jgui/Relays-Board-CAN-24FormC/README.md

# Relays-Board-CAN-24FormC
Board with 24 relays (Form C) controlled by CAN.
