jgui/Relays-Board-CAN-24FormC/PCB/RelaysCAN.kicad_pcb

## KiCad design PCB/RelaysCAN.kicad_pcb (2021-08-17)

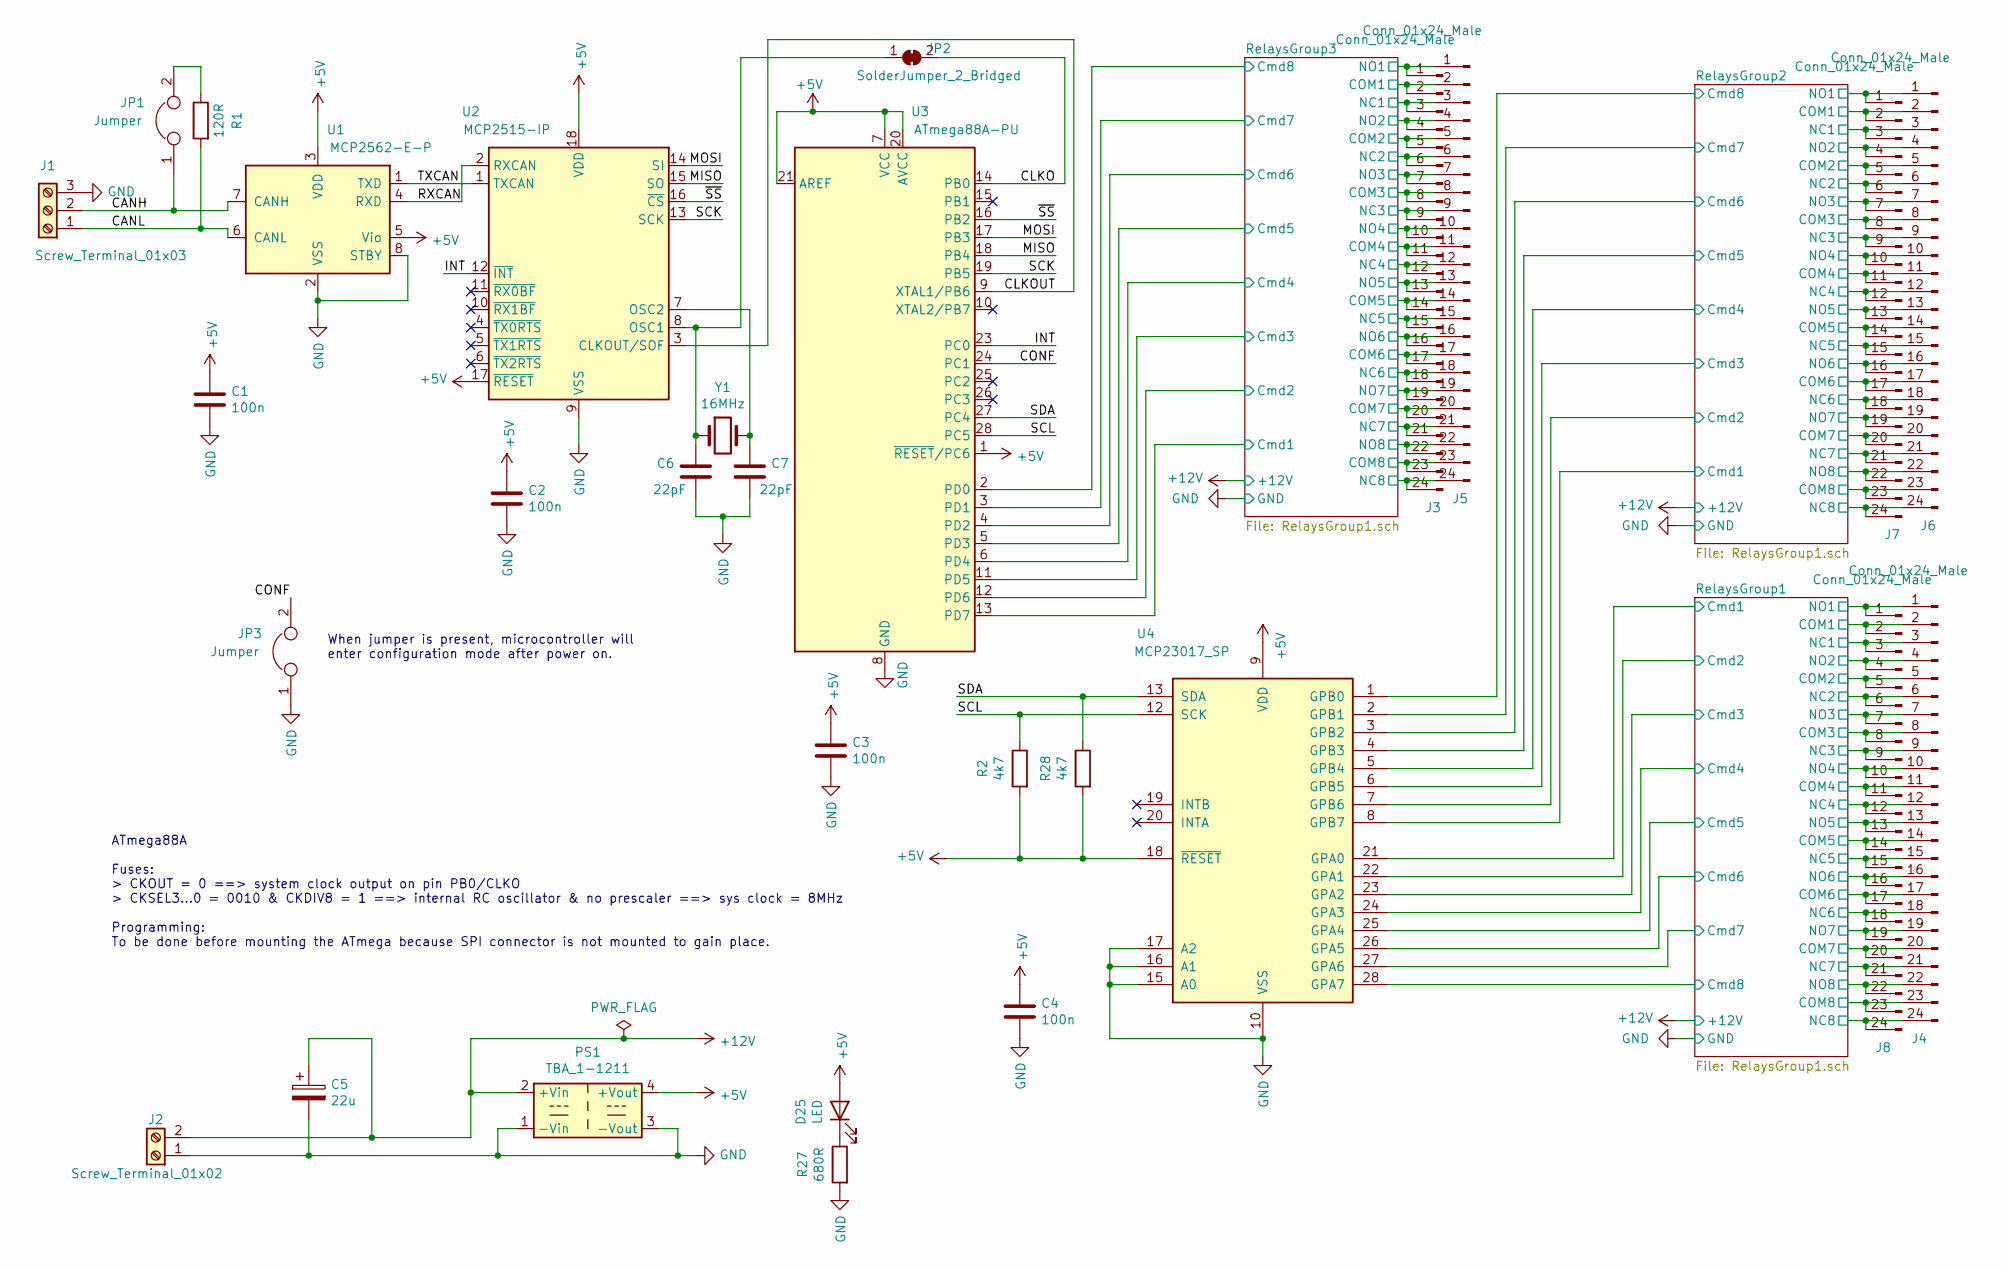
[picture p1: schematic RelaysCAN.sch, Relay board controlled by CAN.]

Parts:
C1, C2, C3, C4: 100n; C_Disc_D4.3mm_W1.9mm_P5.00mm
C5: 22u; CP_Radial_D5.0mm_P2.50mm
C6, C7: 22pF; C_Disc_D4.3mm_W1.9mm_P5.00mm
D25: LED; LED_D3.0mm
J1: Screw_Terminal_01x03; TerminalBlock_bornier-3_P5.08mm
J2: Screw_Terminal_01x02; TerminalBlock_bornier-2_P5.08mm
J3, J7, J8: Conn_01x24_Male; DualSideEdge_65x250mils_2.54mmx24pads
J4, J5, J6: Conn_01x24_Male; PinHeader_1x24_P2.54mm_Vertical
JP1, JP3: Jumper; PinHeader_1x02_P2.54mm_Vertical
JP2: SolderJumper_2_Bridged; SolderJumper-2_P1.3mm_Open_RoundedPad1.0x1.5mm
PS1: TBA_1-1211; Converter_DCDC_TRACO_TBA-1-xxxx_Single_THT
R1: 120R; R_Axial_DIN0207_L6.3mm_D2.5mm_P5.08mm_Vertical
R2, R28: 4k7; R_Axial_DIN0207_L6.3mm_D2.5mm_P5.08mm_Vertical
R27: 680R; R_Axial_DIN0207_L6.3mm_D2.5mm_P5.08mm_Vertical
U1: MCP2562-E-P; DIP-8_W7.62mm
U2: MCP2515-IP; DIP-18_W7.62mm_LongPads
U3: ATmega88A-PU; DIP-28_W7.62mm_LongPads
U4: MCP23017_SP; DIP-28_W7.62mm_LongPads
Y1: 16MHz; Crystal_HC18-U_Vertical

Connections:
+5V: C1.1, C2.1, C3.1, C4.1, D25.2 (A), PS1.4 (+Vout), R2.2, R28.2, U1.3 (VDD), U1.5 (Vio), U2.17 (~RESET), U2.18 (VDD), U3.1 (~RESET~/PC6), U3.7 (VCC), U3.20 (AVCC), U3.21 (AREF), U4.9 (VDD), U4.18 (~RESET~)
+12V: C5.1, J2.2, PS1.2 (+Vin); also elsewhere on the board
/CANH: J1.2, JP1.1, U1.7 (CANH)
/CANL: J1.1, R1.2, U1.6 (CANL)
/CLKO: JP2.2 (B), U3.14 (PB0)
/CLKOUT: U2.3 (CLKOUT/SOF), U3.9 (XTAL1/PB6)
/CONF: JP3.2, U3.24 (PC1)
/INT: U2.12 (~INT), U3.23 (PC0)
/MISO: U2.15 (SO), U3.18 (PB4)
/MOSI: U2.14 (SI), U3.17 (PB3)
/RXCAN: U1.4 (RXD), U2.2 (RXCAN)
/RelaysGroup1/COM1: J4.2, J8.2; also elsewhere on the board
/RelaysGroup1/COM2: J4.5, J8.5; also elsewhere on the board
/RelaysGroup1/COM3: J4.8, J8.8; also elsewhere on the board
/RelaysGroup1/COM4: J4.11, J8.11; also elsewhere on the board
/RelaysGroup1/COM5: J4.14, J8.14; also elsewhere on the board
/RelaysGroup1/COM6: J4.17, J8.17; also elsewhere on the board
/RelaysGroup1/COM7: J4.20, J8.20; also elsewhere on the board
/RelaysGroup1/COM8: J4.23, J8.23; also elsewhere on the board
/RelaysGroup1/Cmd1: U4.21 (GPA0); also elsewhere on the board
/RelaysGroup1/Cmd2: U4.22 (GPA1); also elsewhere on the board
/RelaysGroup1/Cmd3: U4.23 (GPA2); also elsewhere on the board
/RelaysGroup1/Cmd4: U4.24 (GPA3); also elsewhere on the board
/RelaysGroup1/Cmd5: U4.25 (GPA4); also elsewhere on the board
/RelaysGroup1/Cmd6: U4.26 (GPA5); also elsewhere on the board
/RelaysGroup1/Cmd7: U4.27 (GPA6); also elsewhere on the board
/RelaysGroup1/Cmd8: U4.28 (GPA7); also elsewhere on the board
/RelaysGroup1/NC1: J4.3, J8.3; also elsewhere on the board
/RelaysGroup1/NC2: J4.6, J8.6; also elsewhere on the board
/RelaysGroup1/NC3: J4.9, J8.9; also elsewhere on the board
/RelaysGroup1/NC4: J4.12, J8.12; also elsewhere on the board
/RelaysGroup1/NC5: J4.15, J8.15; also elsewhere on the board
/RelaysGroup1/NC6: J4.18, J8.18; also elsewhere on the board
/RelaysGroup1/NC7: J4.21, J8.21; also elsewhere on the board
/RelaysGroup1/NC8: J4.24, J8.24; also elsewhere on the board
/RelaysGroup1/NO1: J4.1, J8.1; also elsewhere on the board
/RelaysGroup1/NO2: J4.4, J8.4; also elsewhere on the board
/RelaysGroup1/NO3: J4.7, J8.7; also elsewhere on the board
/RelaysGroup1/NO4: J4.10, J8.10; also elsewhere on the board
/RelaysGroup1/NO5: J4.13, J8.13; also elsewhere on the board
/RelaysGroup1/NO6: J4.16, J8.16; also elsewhere on the board
/RelaysGroup1/NO7: J4.19, J8.19; also elsewhere on the board
/RelaysGroup1/NO8: J4.22, J8.22; also elsewhere on the board
/RelaysGroup2/COM1: J6.2, J7.2; also elsewhere on the board
/RelaysGroup2/COM2: J6.5, J7.5; also elsewhere on the board
/RelaysGroup2/COM3: J6.8, J7.8; also elsewhere on the board
/RelaysGroup2/COM4: J6.11, J7.11; also elsewhere on the board
/RelaysGroup2/COM5: J6.14, J7.14; also elsewhere on the board
/RelaysGroup2/COM6: J6.17, J7.17; also elsewhere on the board
/RelaysGroup2/COM7: J6.20, J7.20; also elsewhere on the board
/RelaysGroup2/COM8: J6.23, J7.23; also elsewhere on the board
/RelaysGroup2/Cmd1: U4.8 (GPB7); also elsewhere on the board
/RelaysGroup2/Cmd2: U4.7 (GPB6); also elsewhere on the board
/RelaysGroup2/Cmd3: U4.6 (GPB5); also elsewhere on the board
/RelaysGroup2/Cmd4: U4.5 (GPB4); also elsewhere on the board
/RelaysGroup2/Cmd5: U4.4 (GPB3); also elsewhere on the board
/RelaysGroup2/Cmd6: U4.3 (GPB2); also elsewhere on the board
/RelaysGroup2/Cmd7: U4.2 (GPB1); also elsewhere on the board
/RelaysGroup2/Cmd8: U4.1 (GPB0); also elsewhere on the board
/RelaysGroup2/NC1: J6.3, J7.3; also elsewhere on the board
/RelaysGroup2/NC2: J6.6, J7.6; also elsewhere on the board
/RelaysGroup2/NC3: J6.9, J7.9; also elsewhere on the board
/RelaysGroup2/NC4: J6.12, J7.12; also elsewhere on the board
/RelaysGroup2/NC5: J6.15, J7.15; also elsewhere on the board
/RelaysGroup2/NC6: J6.18, J7.18; also elsewhere on the board
/RelaysGroup2/NC7: J6.21, J7.21; also elsewhere on the board
/RelaysGroup2/NC8: J6.24, J7.24; also elsewhere on the board
/RelaysGroup2/NO1: J6.1, J7.1; also elsewhere on the board
/RelaysGroup2/NO2: J6.4, J7.4; also elsewhere on the board
/RelaysGroup2/NO3: J6.7, J7.7; also elsewhere on the board
/RelaysGroup2/NO4: J6.10, J7.10; also elsewhere on the board
/RelaysGroup2/NO5: J6.13, J7.13; also elsewhere on the board
/RelaysGroup2/NO6: J6.16, J7.16; also elsewhere on the board
/RelaysGroup2/NO7: J6.19, J7.19; also elsewhere on the board
/RelaysGroup2/NO8: J6.22, J7.22; also elsewhere on the board
/RelaysGroup3/COM1: J3.2, J5.2; also elsewhere on the board
/RelaysGroup3/COM2: J3.5, J5.5; also elsewhere on the board
/RelaysGroup3/COM3: J3.8, J5.8; also elsewhere on the board
/RelaysGroup3/COM4: J3.11, J5.11; also elsewhere on the board
/RelaysGroup3/COM5: J3.14, J5.14; also elsewhere on the board
/RelaysGroup3/COM6: J3.17, J5.17; also elsewhere on the board
/RelaysGroup3/COM7: J3.20, J5.20; also elsewhere on the board
/RelaysGroup3/COM8: J3.23, J5.23; also elsewhere on the board
/RelaysGroup3/Cmd1: U3.13 (PD7); also elsewhere on the board
/RelaysGroup3/Cmd2: U3.12 (PD6); also elsewhere on the board
/RelaysGroup3/Cmd3: U3.11 (PD5); also elsewhere on the board
/RelaysGroup3/Cmd4: U3.6 (PD4); also elsewhere on the board
/RelaysGroup3/Cmd5: U3.5 (PD3); also elsewhere on the board
/RelaysGroup3/Cmd6: U3.4 (PD2); also elsewhere on the board
/RelaysGroup3/Cmd7: U3.3 (PD1); also elsewhere on the board
/RelaysGroup3/Cmd8: U3.2 (PD0); also elsewhere on the board
/RelaysGroup3/NC1: J3.3, J5.3; also elsewhere on the board
/RelaysGroup3/NC2: J3.6, J5.6; also elsewhere on the board
/RelaysGroup3/NC3: J3.9, J5.9; also elsewhere on the board
/RelaysGroup3/NC4: J3.12, J5.12; also elsewhere on the board
/RelaysGroup3/NC5: J3.15, J5.15; also elsewhere on the board
/RelaysGroup3/NC6: J3.18, J5.18; also elsewhere on the board
/RelaysGroup3/NC7: J3.21, J5.21; also elsewhere on the board
/RelaysGroup3/NC8: J3.24, J5.24; also elsewhere on the board
/RelaysGroup3/NO1: J3.1, J5.1; also elsewhere on the board
/RelaysGroup3/NO2: J3.4, J5.4; also elsewhere on the board
/RelaysGroup3/NO3: J3.7, J5.7; also elsewhere on the board
/RelaysGroup3/NO4: J3.10, J5.10; also elsewhere on the board
/RelaysGroup3/NO5: J3.13, J5.13; also elsewhere on the board
/RelaysGroup3/NO6: J3.16, J5.16; also elsewhere on the board
/RelaysGroup3/NO7: J3.19, J5.19; also elsewhere on the board
/RelaysGroup3/NO8: J3.22, J5.22; also elsewhere on the board
/SCK: U2.13 (SCK), U3.19 (PB5)
/SCL: R2.1, U3.28 (PC5), U4.12 (SCK)
/SDA: R28.1, U3.27 (PC4), U4.13 (SDA)
/TXCAN: U1.1 (TXD), U2.1 (TXCAN)
/~SS: U2.16 (~CS), U3.16 (PB2)
GND: C1.2, C2.2, C3.2, C4.2, C5.2, C6.2, C7.2, J1.3, J2.1, JP3.1, PS1.1 (-Vin), PS1.3 (-Vout), R27.2, U1.2 (VSS), U1.8 (STBY), U2.9 (VSS), U3.8 (GND), U3.22 (GND), U4.10 (VSS), U4.15 (A0), U4.16 (A1), U4.17 (A2); also elsewhere on the board
unnamed: C6.1, JP2.1 (A), U2.8 (OSC1), Y1.1
unnamed: C7.1, U2.7 (OSC2), Y1.2
unnamed: D25.1 (K), R27.1
unnamed: JP1.2, R1.1

Notes on the sheet:
ATmega88A Fuses: > CKOUT = 0 ==> system clock output on pin PB0/CLKO > CKSEL3...0 = 0010 & CKDIV8 = 1 ==> internal RC oscillator & no prescaler ==> sys clock = 8MHz Programming: To be done before mounting the ATmega because SPI connector is not mounted to gain place.
When jumper is present, microcontroller will enter configuration mode after power on.

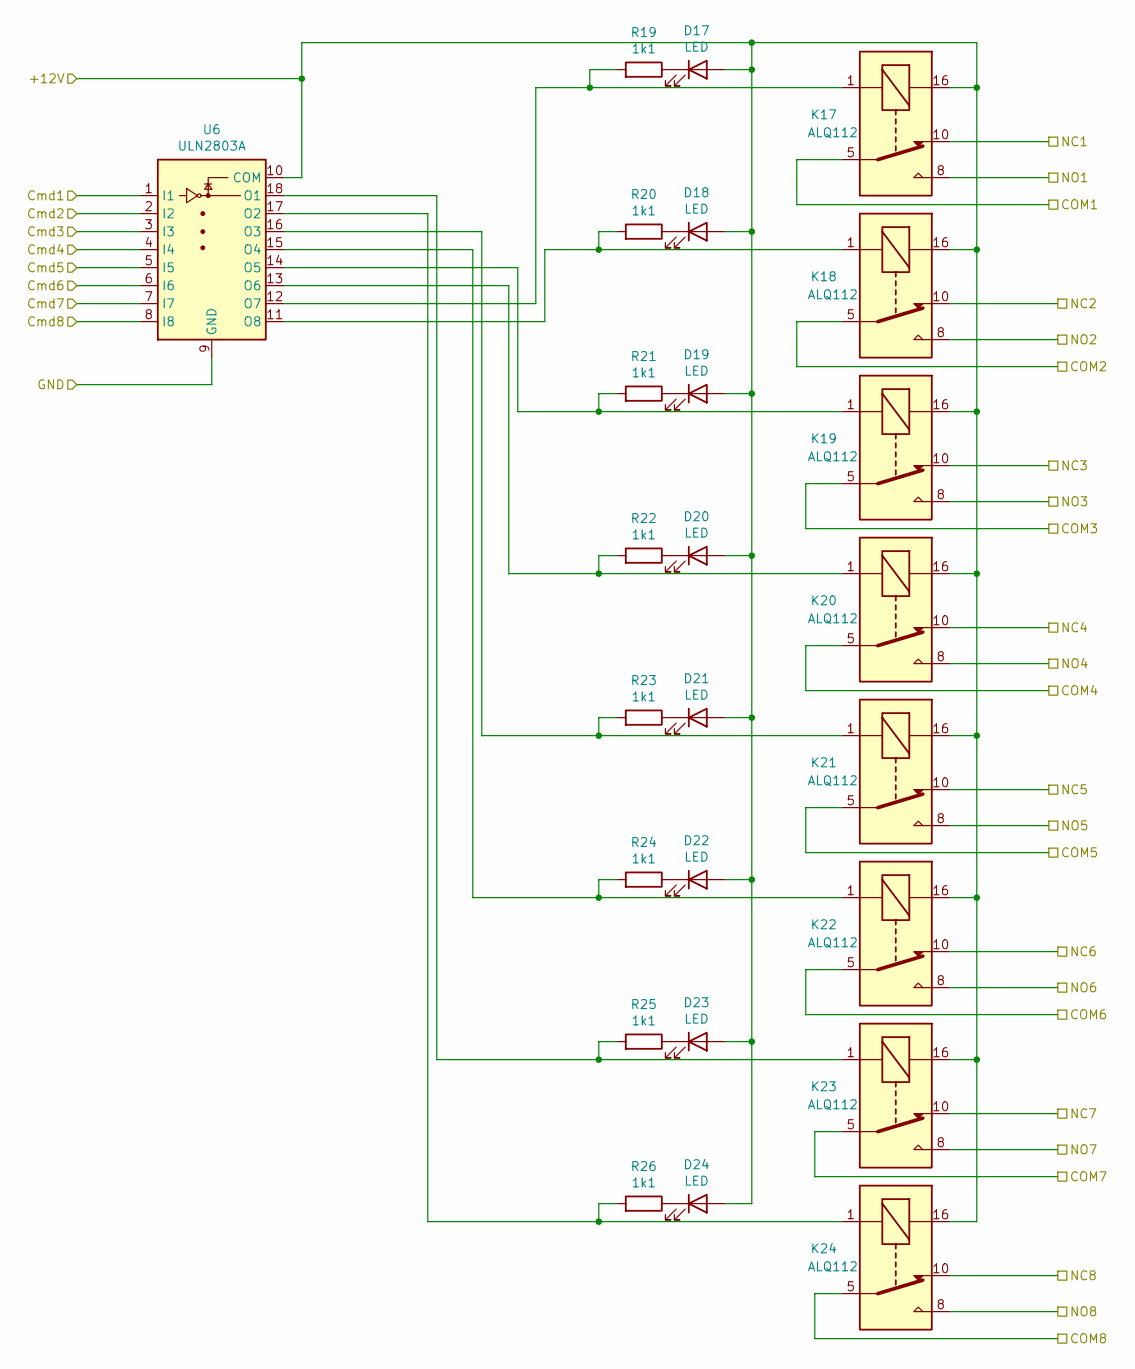
[picture p2: schematic RelaysGroup1.sch, Relay board controlled by CAN.]

Parts:
D1, D2, D3, D4, D5, D6, D7, D8: LED; LED_D3.0mm
K1, K2, K3, K4, K5, K6, K7, K8: ALQ112; Relay_Panasonic_ALQ112
R3, R4, R5, R6, R7, R8, R9, R10: 1k1; R_Axial_DIN0207_L6.3mm_D2.5mm_P5.08mm_Vertical
U7: ULN2803A; DIP-18_W7.62mm_LongPads

Connections:
+12V: D1.2 (A), D2.2 (A), D3.2 (A), D4.2 (A), D5.2 (A), D6.2 (A), D7.2 (A), D8.2 (A), K1.16, K2.16, K3.16, K4.16, K5.16, K6.16, K7.16, K8.16, U7.10 (COM); also elsewhere on the board
/RelaysGroup1/COM1: K1.5; also elsewhere on the board
/RelaysGroup1/COM2: K2.5; also elsewhere on the board
/RelaysGroup1/COM3: K3.5; also elsewhere on the board
/RelaysGroup1/COM4: K4.5; also elsewhere on the board
/RelaysGroup1/COM5: K5.5; also elsewhere on the board
/RelaysGroup1/COM6: K6.5; also elsewhere on the board
/RelaysGroup1/COM7: K7.5; also elsewhere on the board
/RelaysGroup1/COM8: K8.5; also elsewhere on the board
/RelaysGroup1/Cmd1: U7.1 (I1); also elsewhere on the board
/RelaysGroup1/Cmd2: U7.2 (I2); also elsewhere on the board
/RelaysGroup1/Cmd3: U7.3 (I3); also elsewhere on the board
/RelaysGroup1/Cmd4: U7.4 (I4); also elsewhere on the board
/RelaysGroup1/Cmd5: U7.5 (I5); also elsewhere on the board
/RelaysGroup1/Cmd6: U7.6 (I6); also elsewhere on the board
/RelaysGroup1/Cmd7: U7.7 (I7); also elsewhere on the board
/RelaysGroup1/Cmd8: U7.8 (I8); also elsewhere on the board
/RelaysGroup1/NC1: K1.10; also elsewhere on the board
/RelaysGroup1/NC2: K2.10; also elsewhere on the board
/RelaysGroup1/NC3: K3.10; also elsewhere on the board
/RelaysGroup1/NC4: K4.10; also elsewhere on the board
/RelaysGroup1/NC5: K5.10; also elsewhere on the board
/RelaysGroup1/NC6: K6.10; also elsewhere on the board
/RelaysGroup1/NC7: K7.10; also elsewhere on the board
/RelaysGroup1/NC8: K8.10; also elsewhere on the board
/RelaysGroup1/NO1: K1.8; also elsewhere on the board
/RelaysGroup1/NO2: K2.8; also elsewhere on the board
/RelaysGroup1/NO3: K3.8; also elsewhere on the board
/RelaysGroup1/NO4: K4.8; also elsewhere on the board
/RelaysGroup1/NO5: K5.8; also elsewhere on the board
/RelaysGroup1/NO6: K6.8; also elsewhere on the board
/RelaysGroup1/NO7: K7.8; also elsewhere on the board
/RelaysGroup1/NO8: K8.8; also elsewhere on the board
GND: U7.9 (GND); also elsewhere on the board
unnamed: D1.1 (K), R3.1
unnamed: D2.1 (K), R4.1
unnamed: D3.1 (K), R5.1
unnamed: D4.1 (K), R6.1
unnamed: D5.1 (K), R7.1
unnamed: D6.1 (K), R8.1
unnamed: D7.1 (K), R9.1
unnamed: D8.1 (K), R10.1
unnamed: K1.1, R3.2, U7.12 (O7)
unnamed: K2.1, R4.2, U7.11 (O8)
unnamed: K3.1, R5.2, U7.14 (O5)
unnamed: K4.1, R6.2, U7.13 (O6)
unnamed: K5.1, R7.2, U7.16 (O3)
unnamed: K6.1, R8.2, U7.15 (O4)
unnamed: K7.1, R9.2, U7.18 (O1)
unnamed: K8.1, R10.2, U7.17 (O2)

Parts of its further copies:
D9, D10, D11, D12, D13, D14, D15, D16, D17, D18, D19, D20, D21, D22, D23, D24: LED; LED_D3.0mm
K9, K10, K11, K12, K13, K14, K15, K16, K17, K18, K19, K20, K21, K22, K23, K24: ALQ112; Relay_Panasonic_ALQ112
R11, R12, R13, R14, R15, R16, R17, R18, R19, R20, R21, R22, R23, R24, R25, R26: 1k1; R_Axial_DIN0207_L6.3mm_D2.5mm_P5.08mm_Vertical
U5, U6: ULN2803A; DIP-18_W7.62mm_LongPads

Connections of its further copies:
+12V: D9.2 (A), D10.2 (A), D11.2 (A), D12.2 (A), D13.2 (A), D14.2 (A), D15.2 (A), D16.2 (A), D17.2 (A), D18.2 (A), D19.2 (A), D20.2 (A), D21.2 (A), D22.2 (A), D23.2 (A), D24.2 (A), K9.16, K10.16, K11.16, K12.16, K13.16, K14.16, K15.16, K16.16, K17.16, K18.16, K19.16, K20.16, K21.16, K22.16, K23.16, K24.16, U5.10 (COM), U6.10 (COM); also elsewhere on the board
/RelaysGroup2/COM1: K9.5; also elsewhere on the board
/RelaysGroup2/COM2: K10.5; also elsewhere on the board
/RelaysGroup2/COM3: K11.5; also elsewhere on the board
/RelaysGroup2/COM4: K12.5; also elsewhere on the board
/RelaysGroup2/COM5: K13.5; also elsewhere on the board
/RelaysGroup2/COM6: K14.5; also elsewhere on the board
/RelaysGroup2/COM7: K15.5; also elsewhere on the board
/RelaysGroup2/COM8: K16.5; also elsewhere on the board
/RelaysGroup2/Cmd1: U5.1 (I1); also elsewhere on the board
/RelaysGroup2/Cmd2: U5.2 (I2); also elsewhere on the board
/RelaysGroup2/Cmd3: U5.3 (I3); also elsewhere on the board
/RelaysGroup2/Cmd4: U5.4 (I4); also elsewhere on the board
/RelaysGroup2/Cmd5: U5.5 (I5); also elsewhere on the board
/RelaysGroup2/Cmd6: U5.6 (I6); also elsewhere on the board
/RelaysGroup2/Cmd7: U5.7 (I7); also elsewhere on the board
/RelaysGroup2/Cmd8: U5.8 (I8); also elsewhere on the board
/RelaysGroup2/NC1: K9.10; also elsewhere on the board
/RelaysGroup2/NC2: K10.10; also elsewhere on the board
/RelaysGroup2/NC3: K11.10; also elsewhere on the board
/RelaysGroup2/NC4: K12.10; also elsewhere on the board
/RelaysGroup2/NC5: K13.10; also elsewhere on the board
/RelaysGroup2/NC6: K14.10; also elsewhere on the board
/RelaysGroup2/NC7: K15.10; also elsewhere on the board
/RelaysGroup2/NC8: K16.10; also elsewhere on the board
/RelaysGroup2/NO1: K9.8; also elsewhere on the board
/RelaysGroup2/NO2: K10.8; also elsewhere on the board
/RelaysGroup2/NO3: K11.8; also elsewhere on the board
/RelaysGroup2/NO4: K12.8; also elsewhere on the board
/RelaysGroup2/NO5: K13.8; also elsewhere on the board
/RelaysGroup2/NO6: K14.8; also elsewhere on the board
/RelaysGroup2/NO7: K15.8; also elsewhere on the board
/RelaysGroup2/NO8: K16.8; also elsewhere on the board
/RelaysGroup3/COM1: K17.5; also elsewhere on the board
/RelaysGroup3/COM2: K18.5; also elsewhere on the board
/RelaysGroup3/COM3: K19.5; also elsewhere on the board
/RelaysGroup3/COM4: K20.5; also elsewhere on the board
/RelaysGroup3/COM5: K21.5; also elsewhere on the board
/RelaysGroup3/COM6: K22.5; also elsewhere on the board
/RelaysGroup3/COM7: K23.5; also elsewhere on the board
/RelaysGroup3/COM8: K24.5; also elsewhere on the board
/RelaysGroup3/Cmd1: U6.1 (I1); also elsewhere on the board
/RelaysGroup3/Cmd2: U6.2 (I2); also elsewhere on the board
/RelaysGroup3/Cmd3: U6.3 (I3); also elsewhere on the board
/RelaysGroup3/Cmd4: U6.4 (I4); also elsewhere on the board
/RelaysGroup3/Cmd5: U6.5 (I5); also elsewhere on the board
/RelaysGroup3/Cmd6: U6.6 (I6); also elsewhere on the board
/RelaysGroup3/Cmd7: U6.7 (I7); also elsewhere on the board
/RelaysGroup3/Cmd8: U6.8 (I8); also elsewhere on the board
/RelaysGroup3/NC1: K17.10; also elsewhere on the board
/RelaysGroup3/NC2: K18.10; also elsewhere on the board
/RelaysGroup3/NC3: K19.10; also elsewhere on the board
/RelaysGroup3/NC4: K20.10; also elsewhere on the board
/RelaysGroup3/NC5: K21.10; also elsewhere on the board
/RelaysGroup3/NC6: K22.10; also elsewhere on the board
/RelaysGroup3/NC7: K23.10; also elsewhere on the board
/RelaysGroup3/NC8: K24.10; also elsewhere on the board
/RelaysGroup3/NO1: K17.8; also elsewhere on the board
/RelaysGroup3/NO2: K18.8; also elsewhere on the board
/RelaysGroup3/NO3: K19.8; also elsewhere on the board
/RelaysGroup3/NO4: K20.8; also elsewhere on the board
/RelaysGroup3/NO5: K21.8; also elsewhere on the board
/RelaysGroup3/NO6: K22.8; also elsewhere on the board
/RelaysGroup3/NO7: K23.8; also elsewhere on the board
/RelaysGroup3/NO8: K24.8; also elsewhere on the board
GND: U5.9 (GND), U6.9 (GND); also elsewhere on the board
unnamed: D9.1 (K), R11.1
unnamed: D10.1 (K), R12.1
unnamed: D11.1 (K), R13.1
unnamed: D12.1 (K), R14.1
unnamed: D13.1 (K), R15.1
unnamed: D14.1 (K), R16.1
unnamed: D15.1 (K), R17.1
unnamed: D16.1 (K), R18.1
unnamed: D17.1 (K), R19.1
unnamed: D18.1 (K), R20.1
unnamed: D19.1 (K), R21.1
unnamed: D20.1 (K), R22.1
unnamed: D21.1 (K), R23.1
unnamed: D22.1 (K), R24.1
unnamed: D23.1 (K), R25.1
unnamed: D24.1 (K), R26.1
unnamed: K9.1, R11.2, U5.12 (O7)
unnamed: K10.1, R12.2, U5.11 (O8)
unnamed: K11.1, R13.2, U5.14 (O5)
unnamed: K12.1, R14.2, U5.13 (O6)
unnamed: K13.1, R15.2, U5.16 (O3)
unnamed: K14.1, R16.2, U5.15 (O4)
unnamed: K15.1, R17.2, U5.18 (O1)
unnamed: K16.1, R18.2, U5.17 (O2)
unnamed: K17.1, R19.2, U6.12 (O7)
unnamed: K18.1, R20.2, U6.11 (O8)
unnamed: K19.1, R21.2, U6.14 (O5)
unnamed: K20.1, R22.2, U6.13 (O6)
unnamed: K21.1, R23.2, U6.16 (O3)
unnamed: K22.1, R24.2, U6.15 (O4)
unnamed: K23.1, R25.2, U6.18 (O1)
unnamed: K24.1, R26.2, U6.17 (O2)

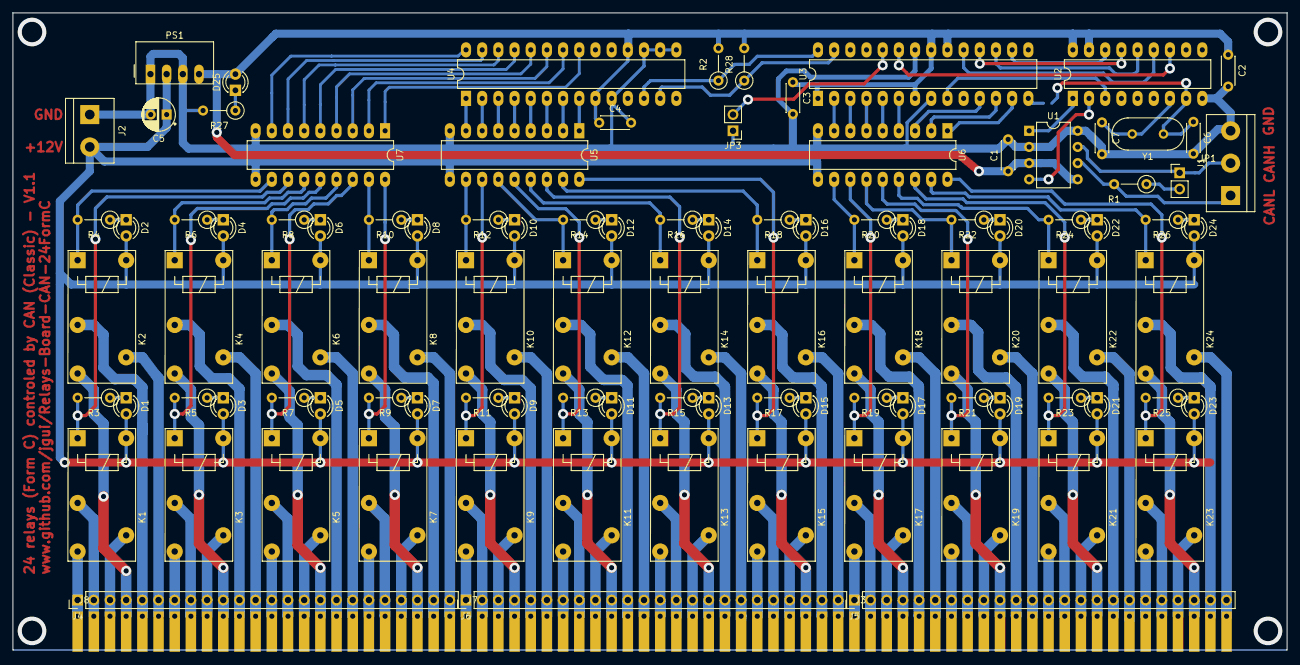
[picture p3: board RelaysCAN.kicad_pcb from above]

Board: 2 copper layers, 200.0 x 100.0 mm, 104 parts (1 on the bottom side), 165 nets.
