jgui/Relays-Board-CAN-24FormC/(commit log)

2021-06-27 Add PCB.
    [RelaysCAN.kicad_pcb, RelaysCAN.sch, RelaysGroup1.sch]
2021-07-17 Update PCB.
    [RelaysCAN.kicad_pcb, RelaysCAN.sch, RelaysGroup1.sch]
2021-08-17 Add the software for the micro-controller.
    [Mapping.xlsx, RelaysCAN24_CANalyzer10.0.cfg]
2021-08-17 Add a jumper to enter configuration mode.
    [RelaysCAN.kicad_pcb, RelaysCAN.sch, RelaysGroup1.sch]
2021-09-15 Add Configuration Mode to software.
    [RelaysCAN24_CANalyzer10.0.cfg, RelaysCAN24_ConfMode_CANalyzer10.0.cfg]
